SourceryOne/modular_cart_and_case/README.md

# Modular Cart and Case from one piece of plywood
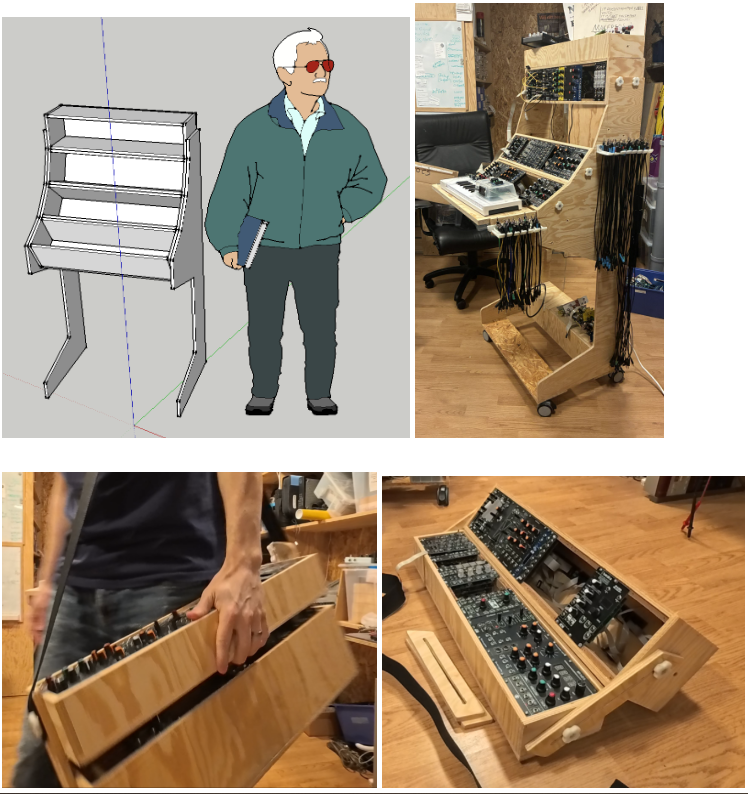
[picture p1: 4in1.png]
