SourceryOne/modular_cart_and_case/Modular cart + case.pdf

# Modular cart + case

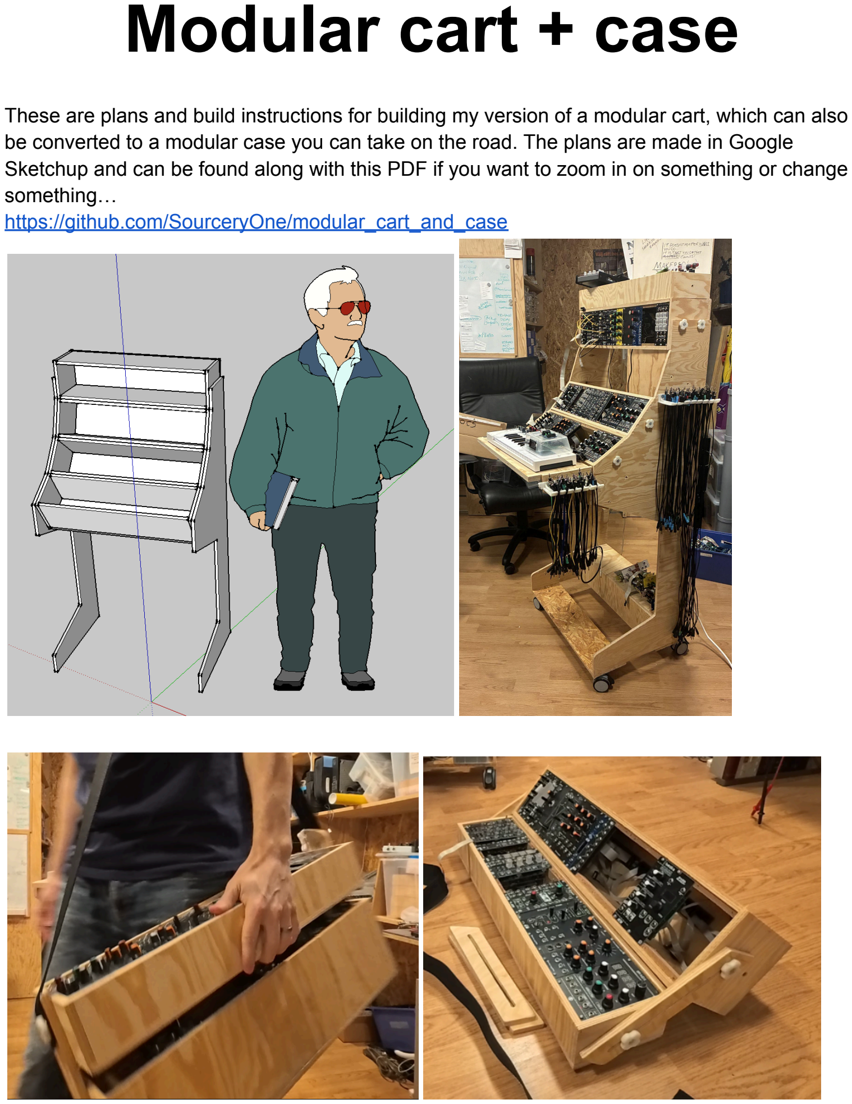
[picture p2: page 1]

These are plans and build instructions for building my version of a modular cart, which can also be converted to a modular case you can take on the road. The plans are made in Google Sketchup and can be found along with this PDF if you want to zoom in on something or change something…
https://github.com/SourceryOne/modular_cart_and_case

This cart can be made with one piece of plywood. You start by cutting out the sides. If you have a plywood with one good side and one ugly side bear in mind that one of the sides of the cart will have an ugly outside, and one an ugly inside. Once that is done you can move on to the boxes for the rows of modules.See next page for a more detailed version of the cart sides.

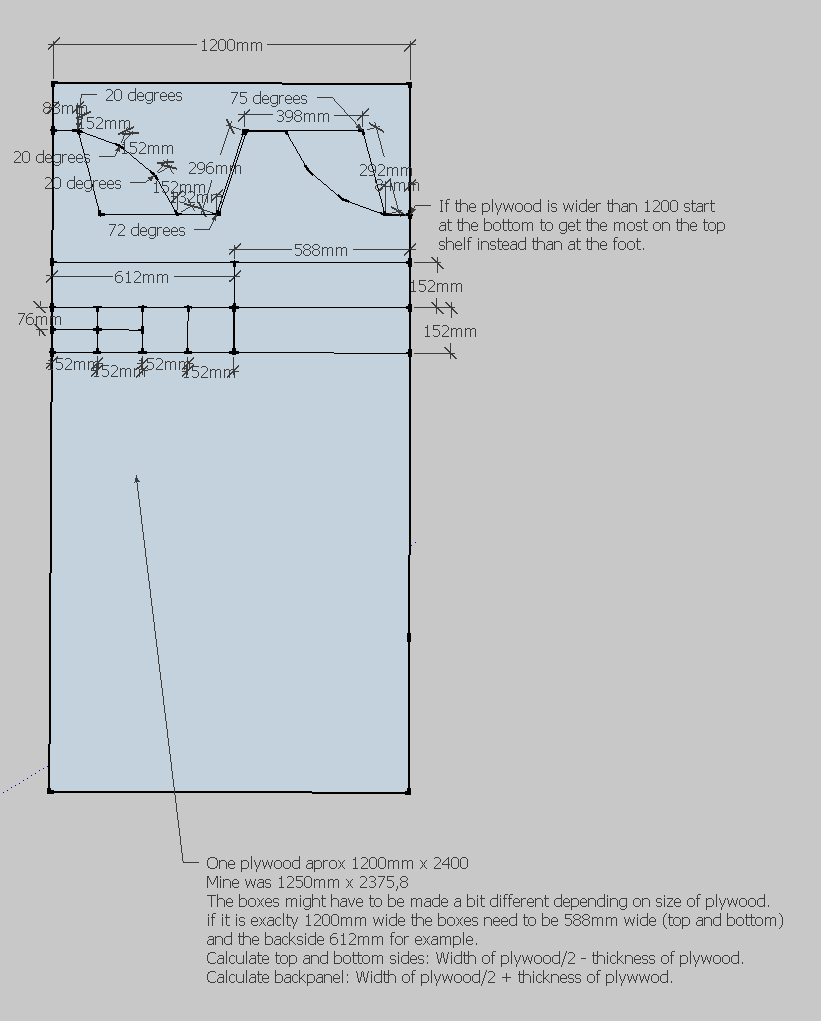
[picture p3: figure]

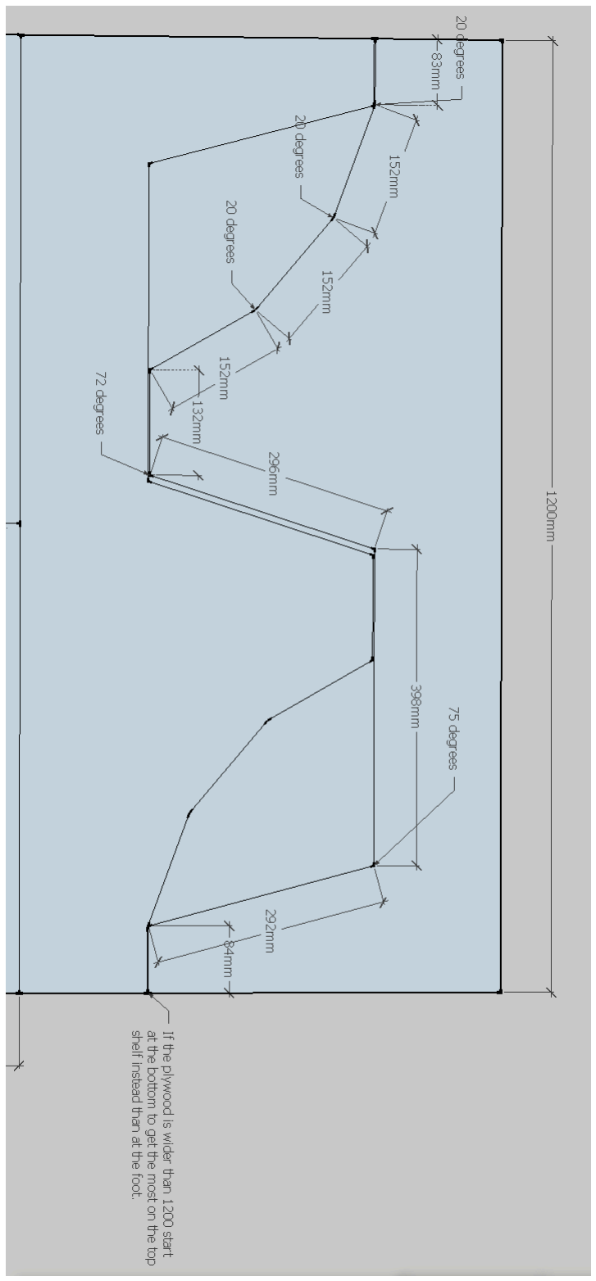
[picture p4: figure]

On the image to the left you should find all measurements to make the two sides of the cart. There are a few gaps where you will get a few small pieces of scrap.

As for the boxes, depending if you want shallow or deep boxes you either go with 152mm or 76mm sides and top and bottom. The backside is the same no matter the depth. I would recommend doing at least one 152mm deep if you have a beefier powersupply or one or two modules that are a little bit deeper. Even though 76cm should take most modules on the market.

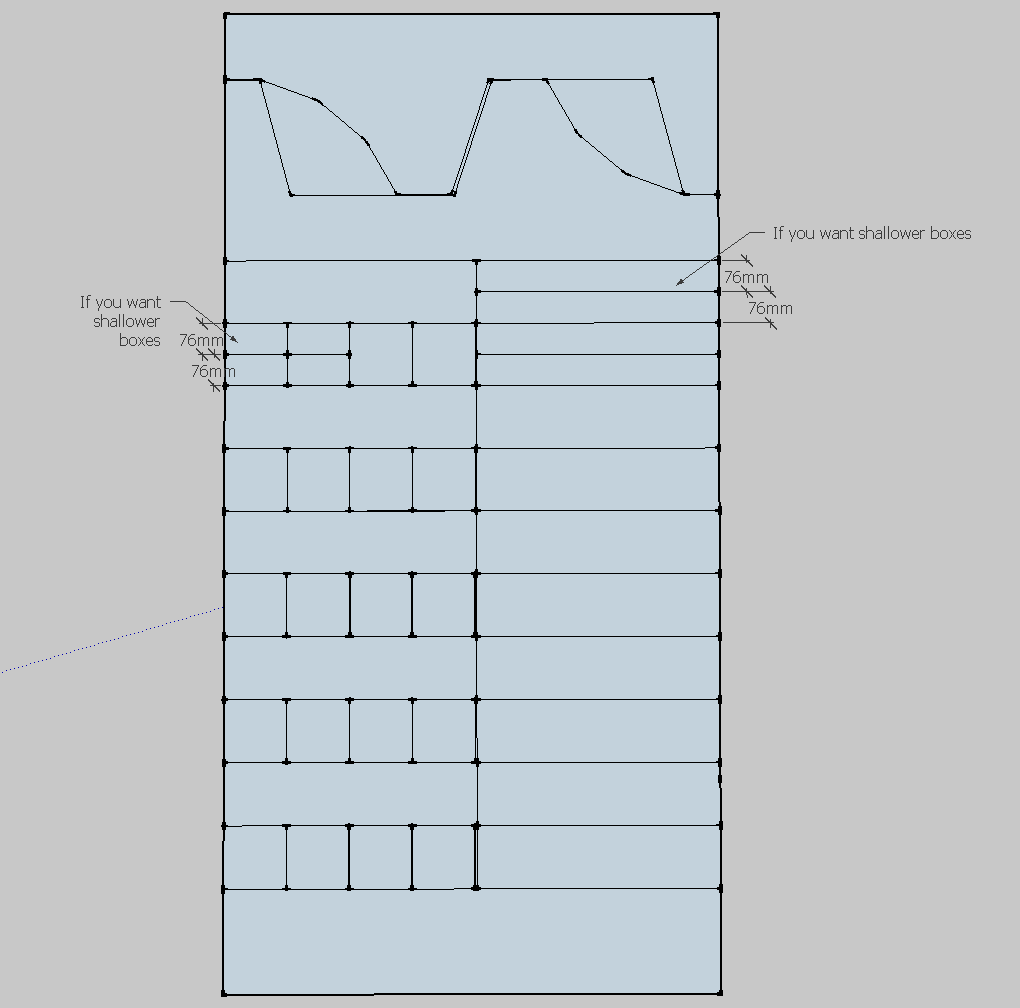
[picture p5: figure]

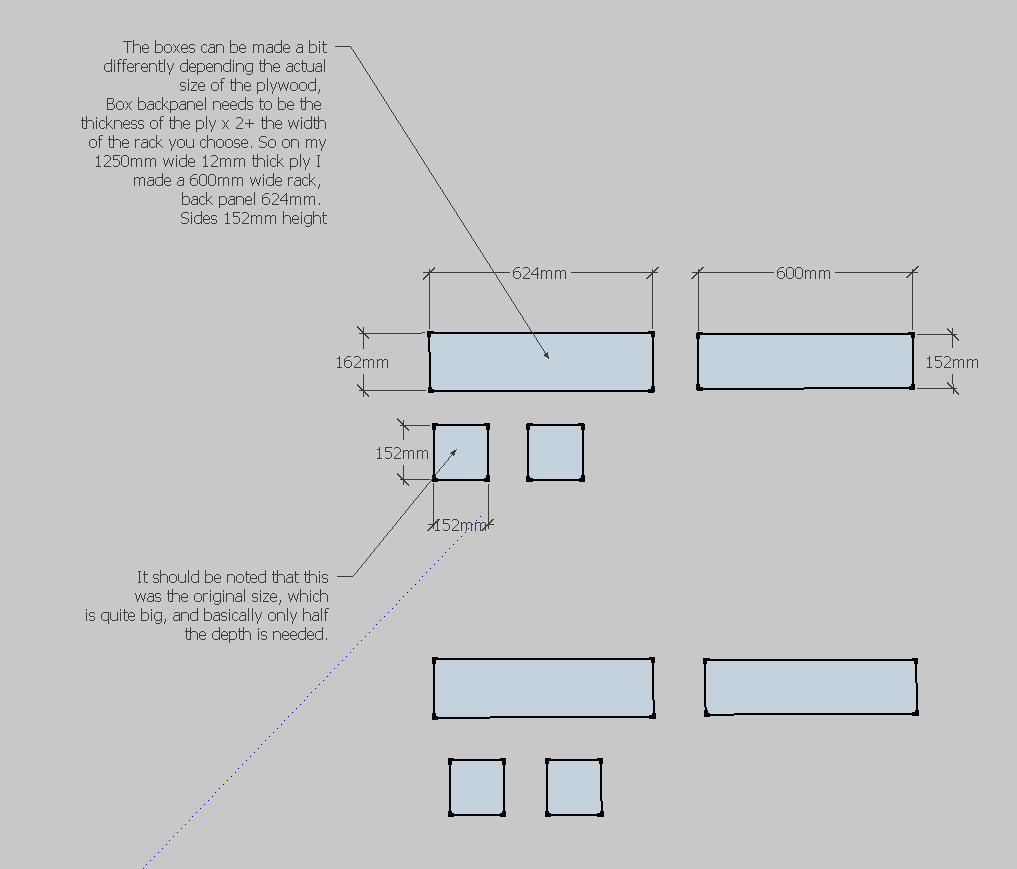
[picture p6: figure]

How to cut and drill the sides of the boxes. So you drill a hole for your insert and then you ofcourse line up this to the cart and make a similar hole there. As you can see it is 152mm, 76mm and 38mm that are the lengths to have in mind. 38mm from the front and back edge (same on the cart) and 76mm the top and bottom edge, also same on the cart.

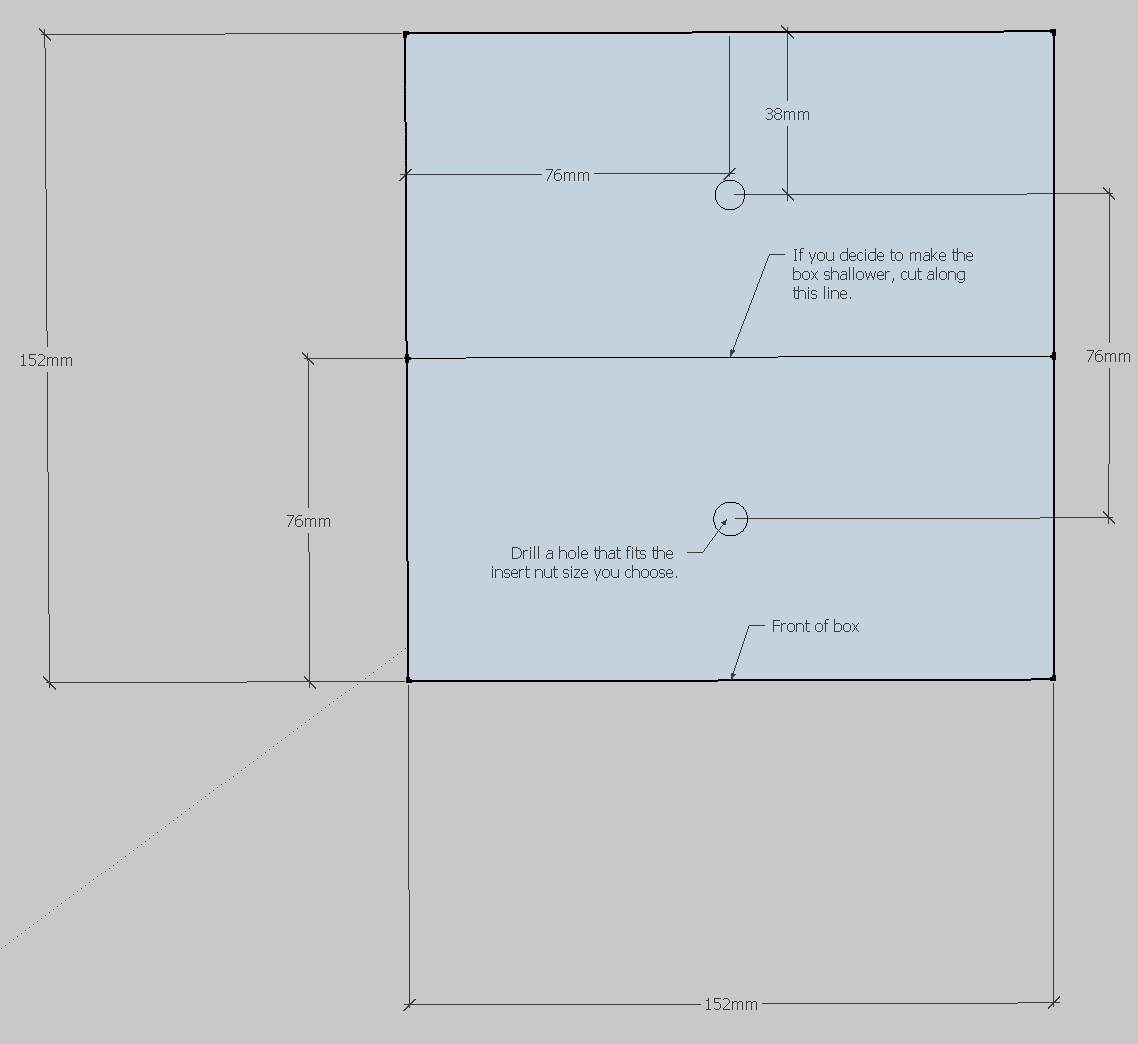
[picture p7: figure]

Once you’ve made the cart and the boxes, you will end up with two of these little triangle bits. One of the things you can make with these is two (or more) rails in each as shown below, that you can use to transform two or three boxes into a carrying case (see image on first page).

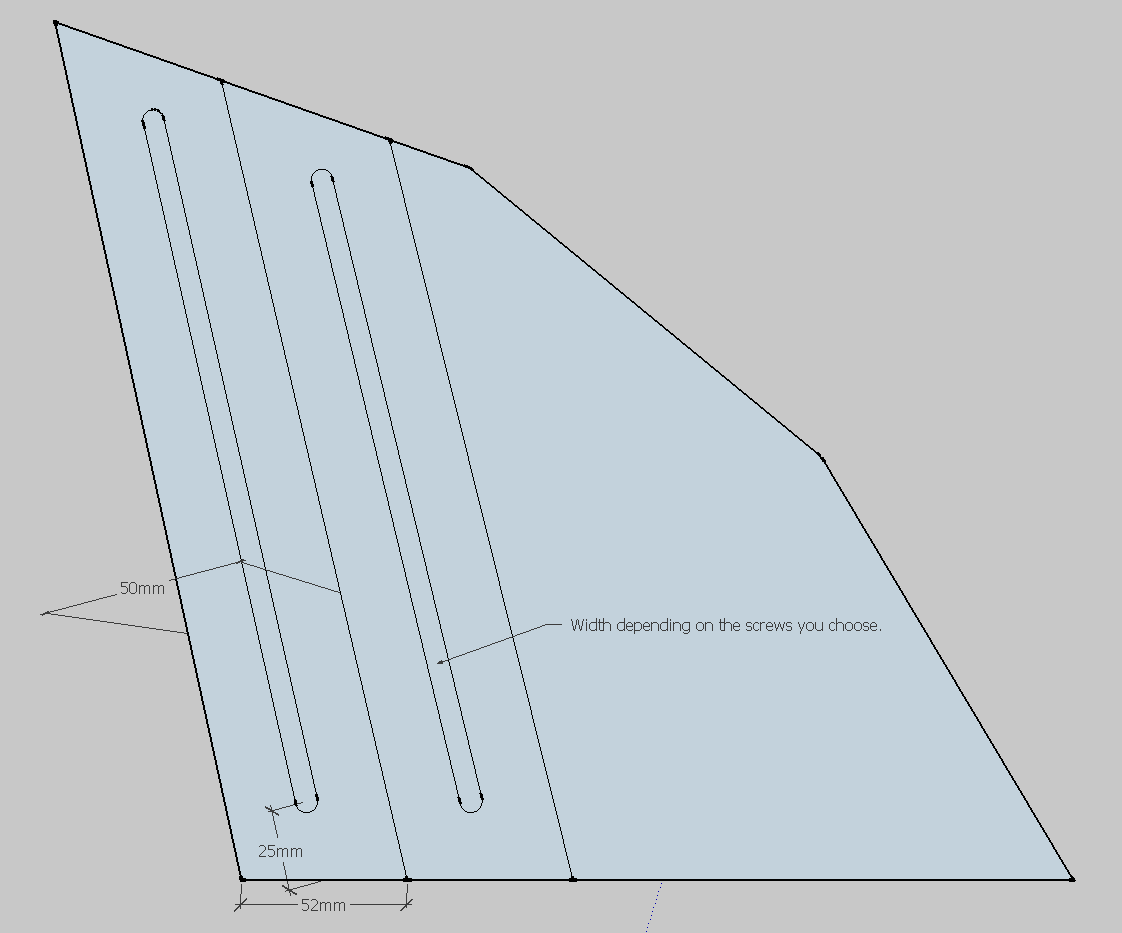
[picture p8: figure]

If you decide to only make two rails as above you can good enough fit the piece below onto the last piece of plywood. The important thing is the 60 degree angle. With this piece you can add the small table I added on the front of my cart for holding my keystep or modules I am working on at the moment, again see image on first page. Use a top or bottom piece for the table top, that should fit nicely between these two pieces. And the ledge should line up well with the lowest box, making a nice edge for you to hold that box if you take it in and out of the cart often.

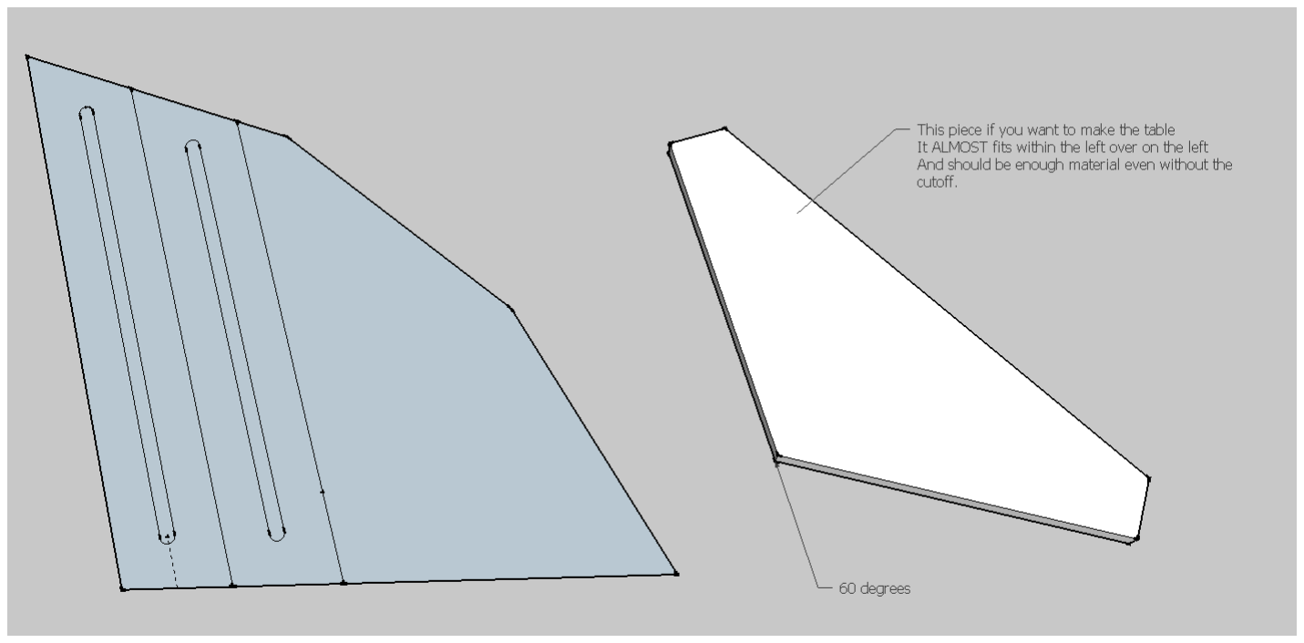
[picture p9: figure]

I really recommend watching the video about this cart to know a few tips and tricks I might have missed here or that is difficult to explain in text.
https://www.youtube.com/watch?v=0L0oqdlzsLg

With all this done you should now have a cart. I realize that some instructions might be missing, please let me know at info@sourcerystudios.se or add a comment on github, and I will try to mitigate this. https://github.com/SourceryOne/modular_cart_and_case
