SourceryOne/modular_cart_and_case/(list of files, cad)

Other CAD files:
Modular cart.skp
