SourceryOne/modular_cart_and_case/(commit log)

2026-05-03 pdf and sketchup make file
    because another mishap with the computer the latest changes to the sketchup file are gone. Will add these. I
    [Modular cart.skp]
2026-05-03 image of the cart/case
